seeigecannon/DC404TrainingBadge/render2.png

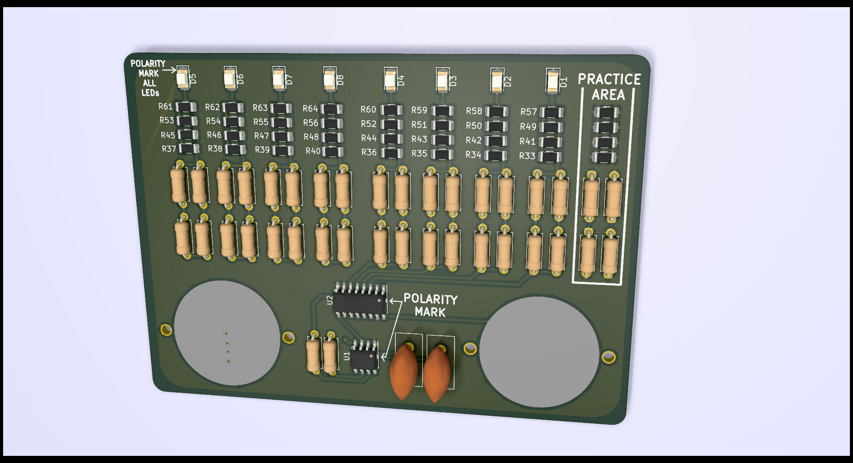
render2.png
