seeigecannon/DC404TrainingBadge/README.md

# DC404TrainingBadge
DC404 Learn to Solder Badge
