seeigecannon/DC404TrainingBadge/render2b.png

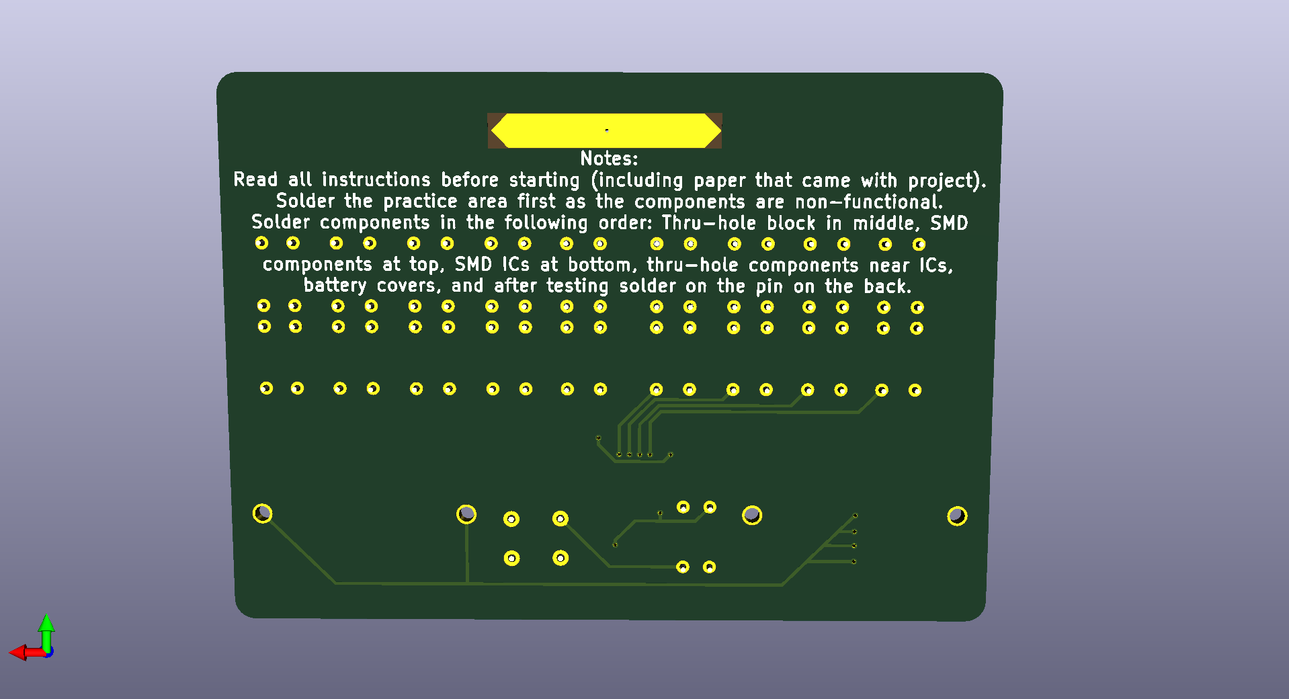
render2b.png
