seeigecannon/DC404TrainingBadge/Printing Print Schematic.pdf

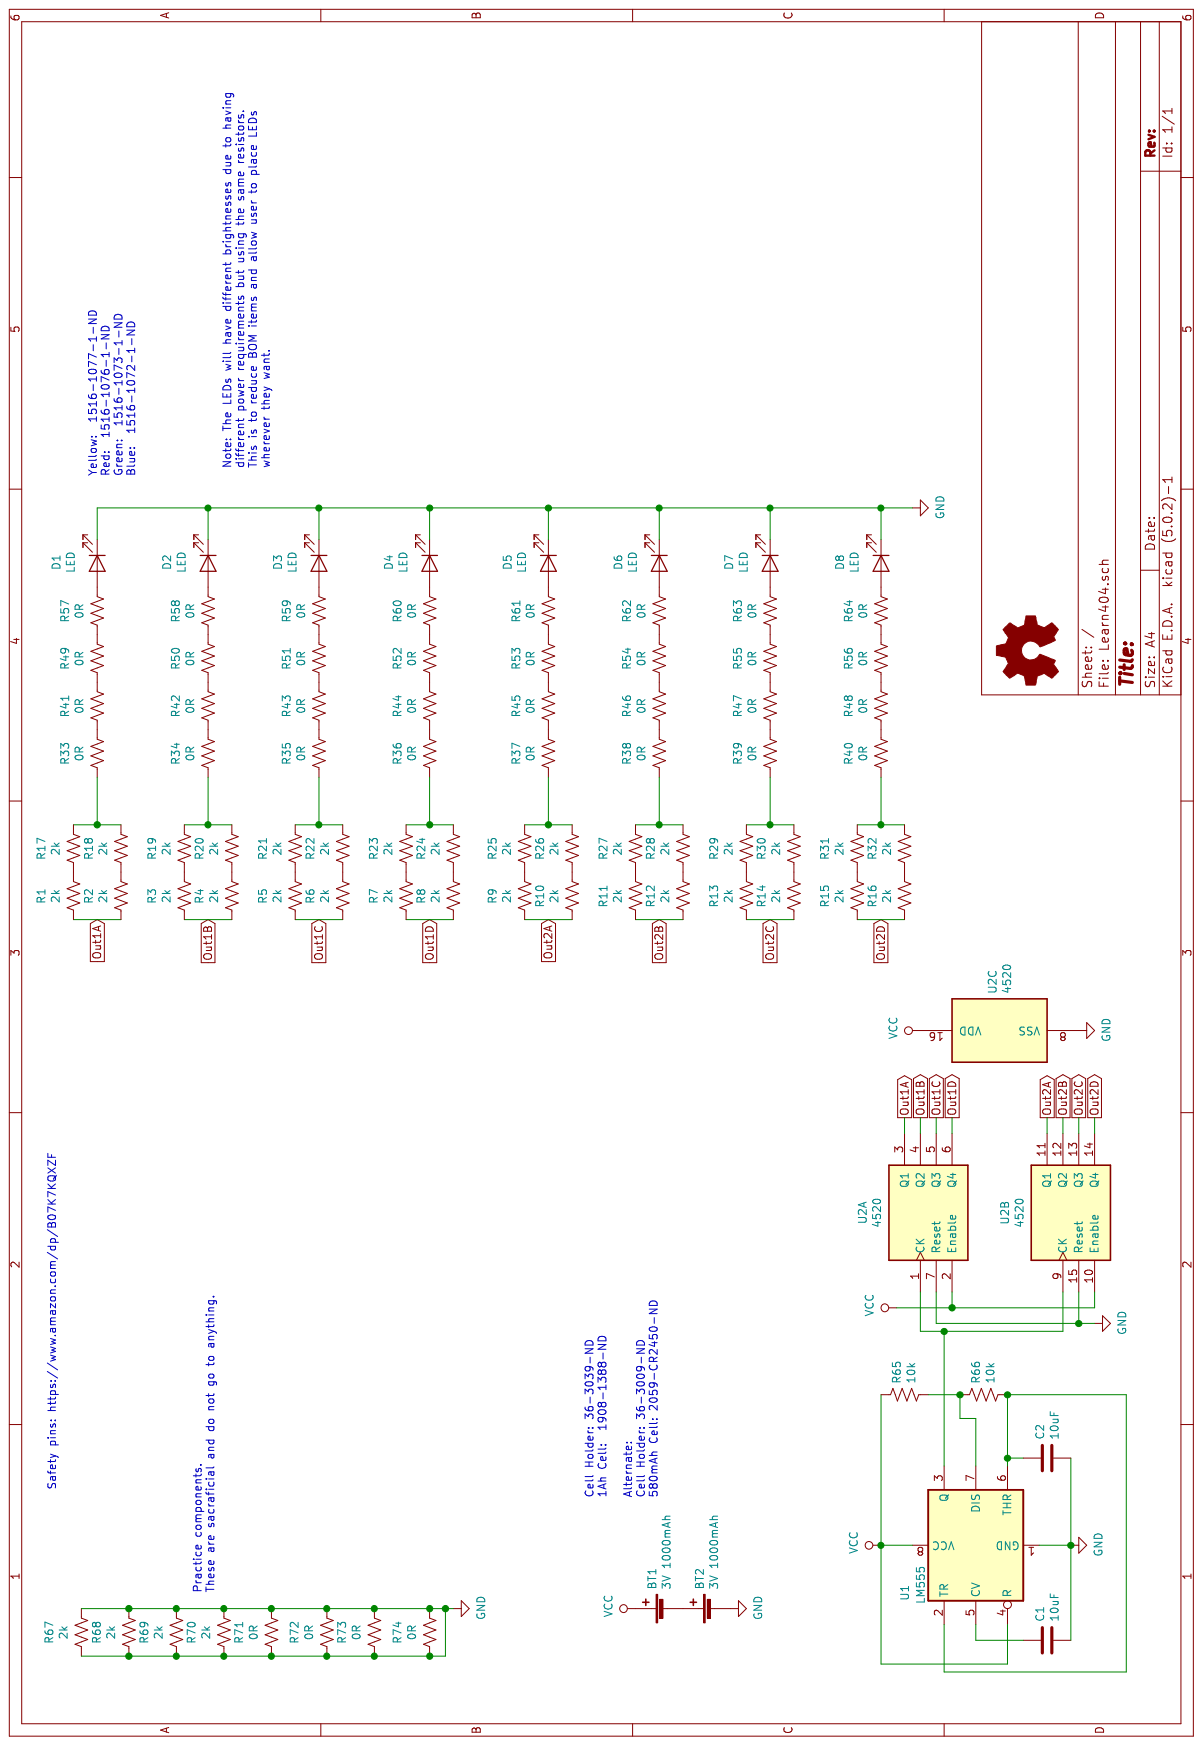
[picture p3: page 1]
