seeigecannon/DC404TrainingBadge/Learn404.kicad_pcb

## KiCad design Learn404.kicad_pcb (2021-06-22)

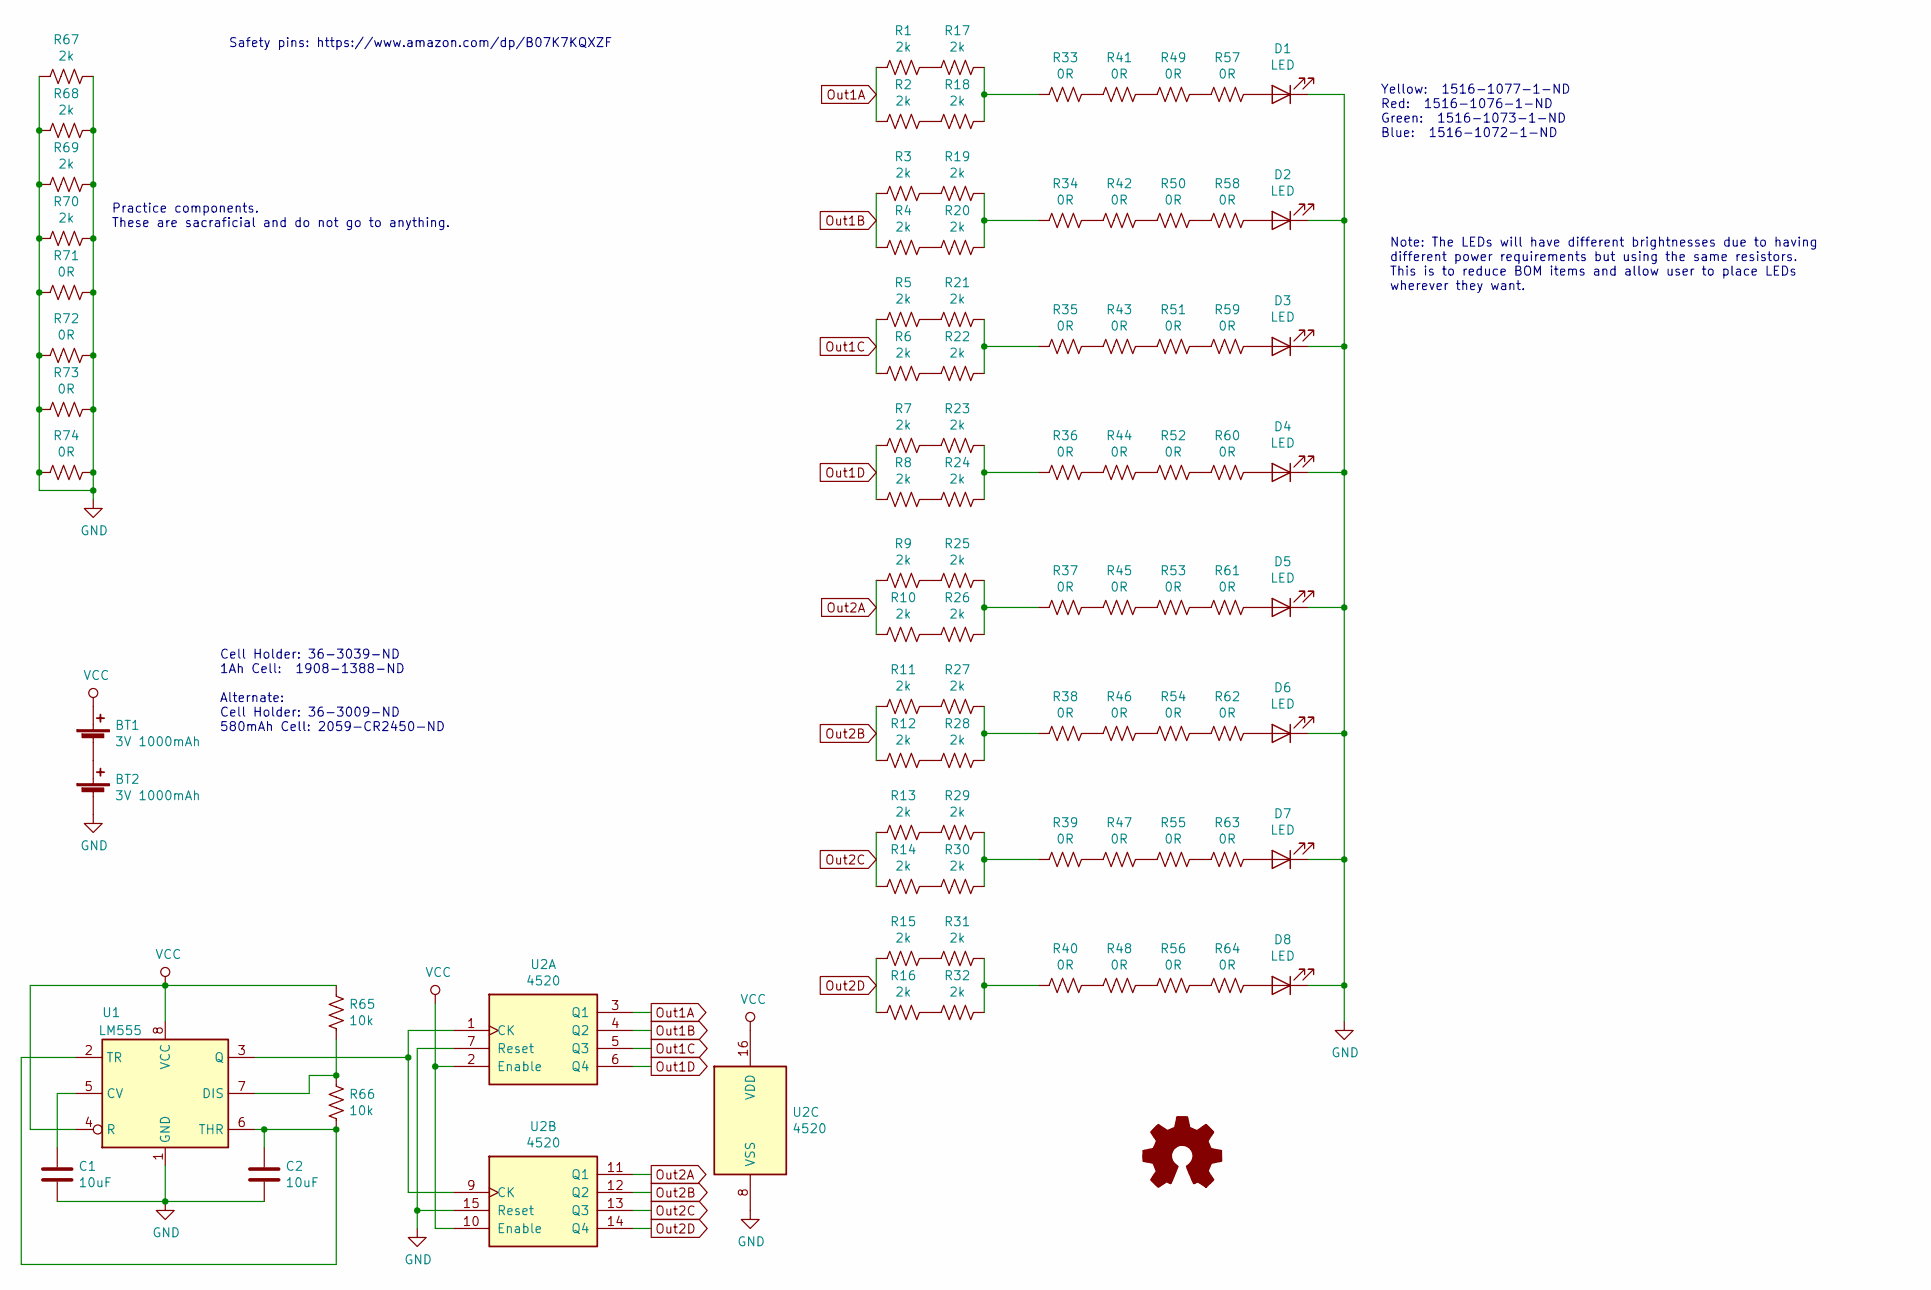
[picture p4: schematic Learn404.sch]

Parts:
BT1, BT2: 3V 1000mAh; BatteryHolder_Keystone_3009_1x2450; PartNum BCAAAPC-ND
C1, C2: 10uF; C_Disc_D10.5mm_W5.0mm_P5.00mm; PartNum FK26X7R1C106K
D1, D2, D3, D4, D5, D6, D7, D8: LED; R_1210_3225Metric_Pad1.42x2.65mm_HandSolder
R1, R2, R3, R4, R5, R6, R7, R8, R9, R10, R11, R12, R13, R14, R15, R16, R17, R18, R19, R20, R21, R22, R23, R24, R25, R26, R27, R28, R29, R30, R31, R32, R67, R68, R69, R70: 2k; R_Axial_DIN0207_L6.3mm_D2.5mm_P10.16mm_Horizontal; Part Number CF14JT2K00CT-ND
R33, R34, R35, R36, R37, R38, R39, R40, R41, R42, R43, R44, R45, R46, R47, R48, R49, R50, R51, R52, R53, R54, R55, R56, R57, R58, R59, R60, R61, R62, R63, R64, R71, R72, R73, R74: 0R; R_1206_3216Metric_Pad1.42x1.75mm_HandSolder; Part Number RMCF1206ZT0R00
R65, R66: 10k; R_Axial_DIN0207_L6.3mm_D2.5mm_P10.16mm_Horizontal; Part Number CF14JT10K0
U1: LM555; SOIC-8_3.9x4.9mm_P1.27mm; PartNum 296-21752-1-ND
U2: 4520; SOIC-16_3.9x9.9mm_P1.27mm; PartNum CD74HCT4520M

Connections:
GND: BT2.2 (-), C1.2, C2.2, D1.1 (K), D2.1 (K), D3.1 (K), D4.1 (K), D5.1 (K), D6.1 (K), D7.1 (K), D8.1 (K), R67.1, R67.2, R68.1, R68.2, R69.1, R69.2, R70.1, R70.2, R71.1, R71.2, R72.1, R72.2, R73.1, R73.2, R74.1, R74.2, U1.1 (GND), U2.7 (Reset), U2.8 (VSS), U2.15 (Reset)
unnamed: BT1.2 (-), BT2.1 (+)
unnamed: C1.1, U1.5 (CV)
unnamed: C2.1, R66.1, U1.2 (TR), U1.6 (THR)
unnamed: D1.2 (A), R57.1
unnamed: D2.2 (A), R58.1
unnamed: D3.2 (A), R59.1
unnamed: D4.2 (A), R60.1
unnamed: D5.2 (A), R61.1
unnamed: D6.2 (A), R62.1
unnamed: D7.2 (A), R63.1
unnamed: D8.2 (A), R64.1
unnamed: R1.1, R17.2
unnamed: R10.1, R26.2
unnamed: R11.1, R27.2
unnamed: R12.1, R28.2
unnamed: R13.1, R29.2
unnamed: R14.1, R30.2
unnamed: R15.1, R31.2
unnamed: R16.1, R32.2
unnamed: R17.1, R18.1, R33.2
unnamed: R2.1, R18.2
unnamed: R19.1, R20.1, R34.2
unnamed: R3.1, R19.2
unnamed: R4.1, R20.2
unnamed: R21.1, R22.1, R35.2
unnamed: R5.1, R21.2
unnamed: R6.1, R22.2
unnamed: R23.1, R24.1, R36.2
unnamed: R7.1, R23.2
unnamed: R8.1, R24.2
unnamed: R25.1, R26.1, R37.2
unnamed: R9.1, R25.2
unnamed: R27.1, R28.1, R38.2
unnamed: R29.1, R30.1, R39.2
unnamed: R31.1, R32.1, R40.2
unnamed: R33.1, R41.2
unnamed: R34.1, R42.2
unnamed: R35.1, R43.2
unnamed: R36.1, R44.2
unnamed: R37.1, R45.2
unnamed: R38.1, R46.2
unnamed: R39.1, R47.2
unnamed: R40.1, R48.2
unnamed: R41.1, R49.2
unnamed: R42.1, R50.2
unnamed: R43.1, R51.2
unnamed: R44.1, R52.2
unnamed: R45.1, R53.2
unnamed: R46.1, R54.2
unnamed: R47.1, R55.2
unnamed: R48.1, R56.2
unnamed: R49.1, R57.2
unnamed: R50.1, R58.2
unnamed: R51.1, R59.2
unnamed: R52.1, R60.2
unnamed: R53.1, R61.2
unnamed: R54.1, R62.2
unnamed: R55.1, R63.2
unnamed: R56.1, R64.2
unnamed: R65.1, R66.2, U1.7 (DIS)
unnamed: U1.3 (Q), U2.1 (CK), U2.9 (CK)
Out1A: R1.2, R2.2, U2.3 (Q1)
Out1B: R3.2, R4.2, U2.4 (Q2)
Out1C: R5.2, R6.2, U2.5 (Q3)
Out1D: R7.2, R8.2, U2.6 (Q4)
Out2A: R9.2, R10.2, U2.11 (Q1)
Out2B: R11.2, R12.2, U2.12 (Q2)
Out2C: R13.2, R14.2, U2.13 (Q3)
Out2D: R15.2, R16.2, U2.14 (Q4)
VCC: BT1.1 (+), R65.2, U1.4 (R), U1.8 (VCC), U2.2 (Enable), U2.10 (Enable), U2.16 (VDD)

Notes on the sheet:
Yellow: 1516-1077-1-ND Red: 1516-1076-1-ND Green: 1516-1073-1-ND Blue: 1516-1072-1-ND
Cell Holder: 36-3039-ND 1Ah Cell: 1908-1388-ND Alternate: Cell Holder: 36-3009-ND 580mAh Cell: 2059-CR2450-ND
Safety pins: https://www.amazon.com/dp/B07K7KQXZF
Practice components. These are sacraficial and do not go to anything.
Note: The LEDs will have different brightnesses due to having different power requirements but using the same resistors. This is to reduce BOM items and allow user to place LEDs wherever they want.

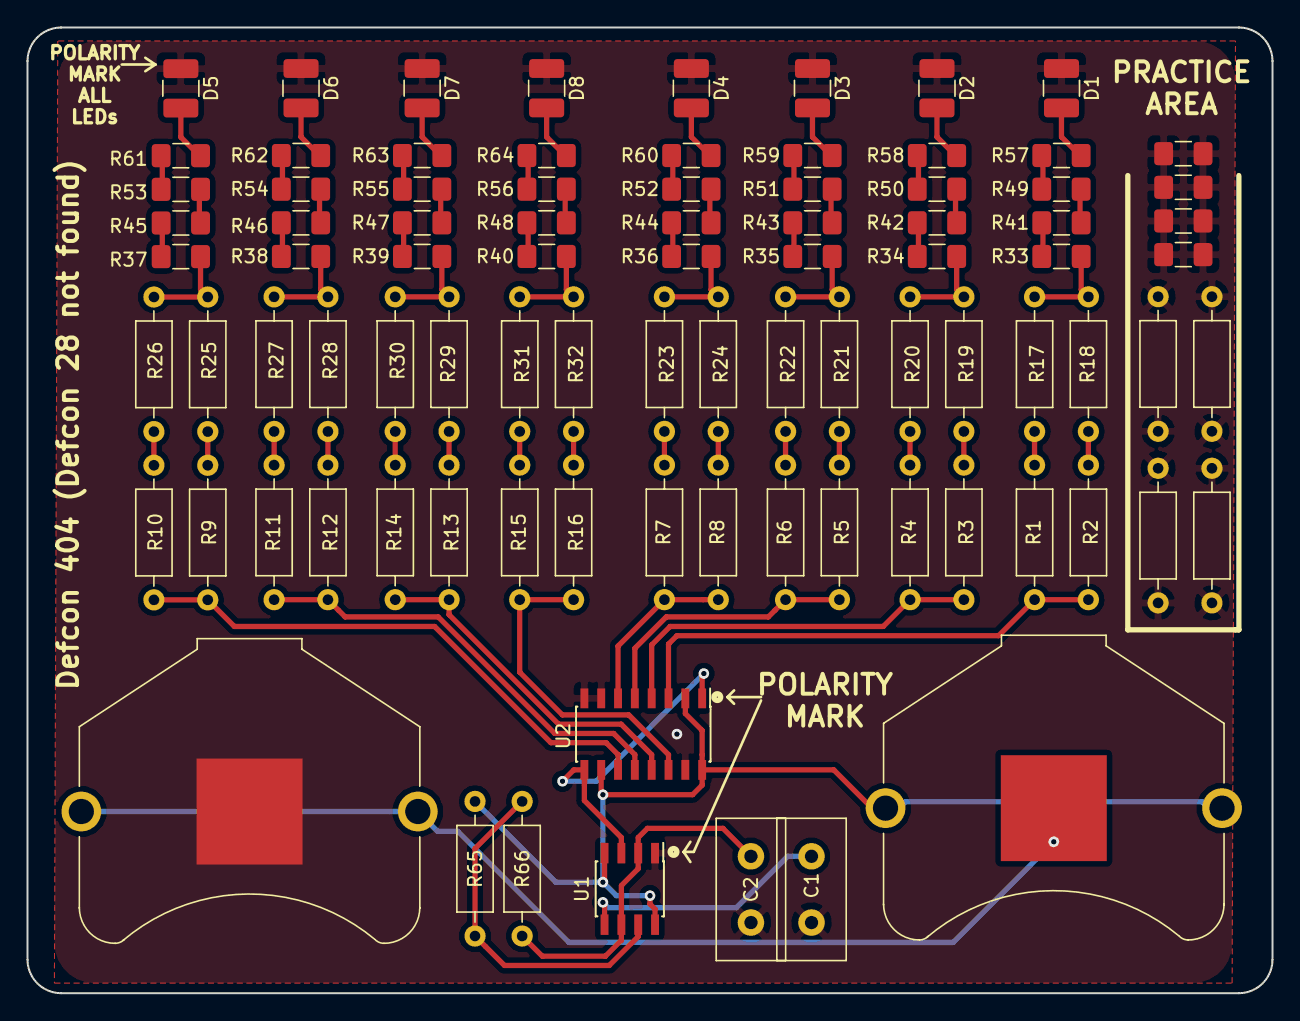
[picture p5: board Learn404.kicad_pcb from above]

Board: 2 copper layers, 94.0 x 72.9 mm, 88 parts (0 on the bottom side), 71 nets.
