seeigecannon/DC404TrainingBadge/Printing Print Schematic.png

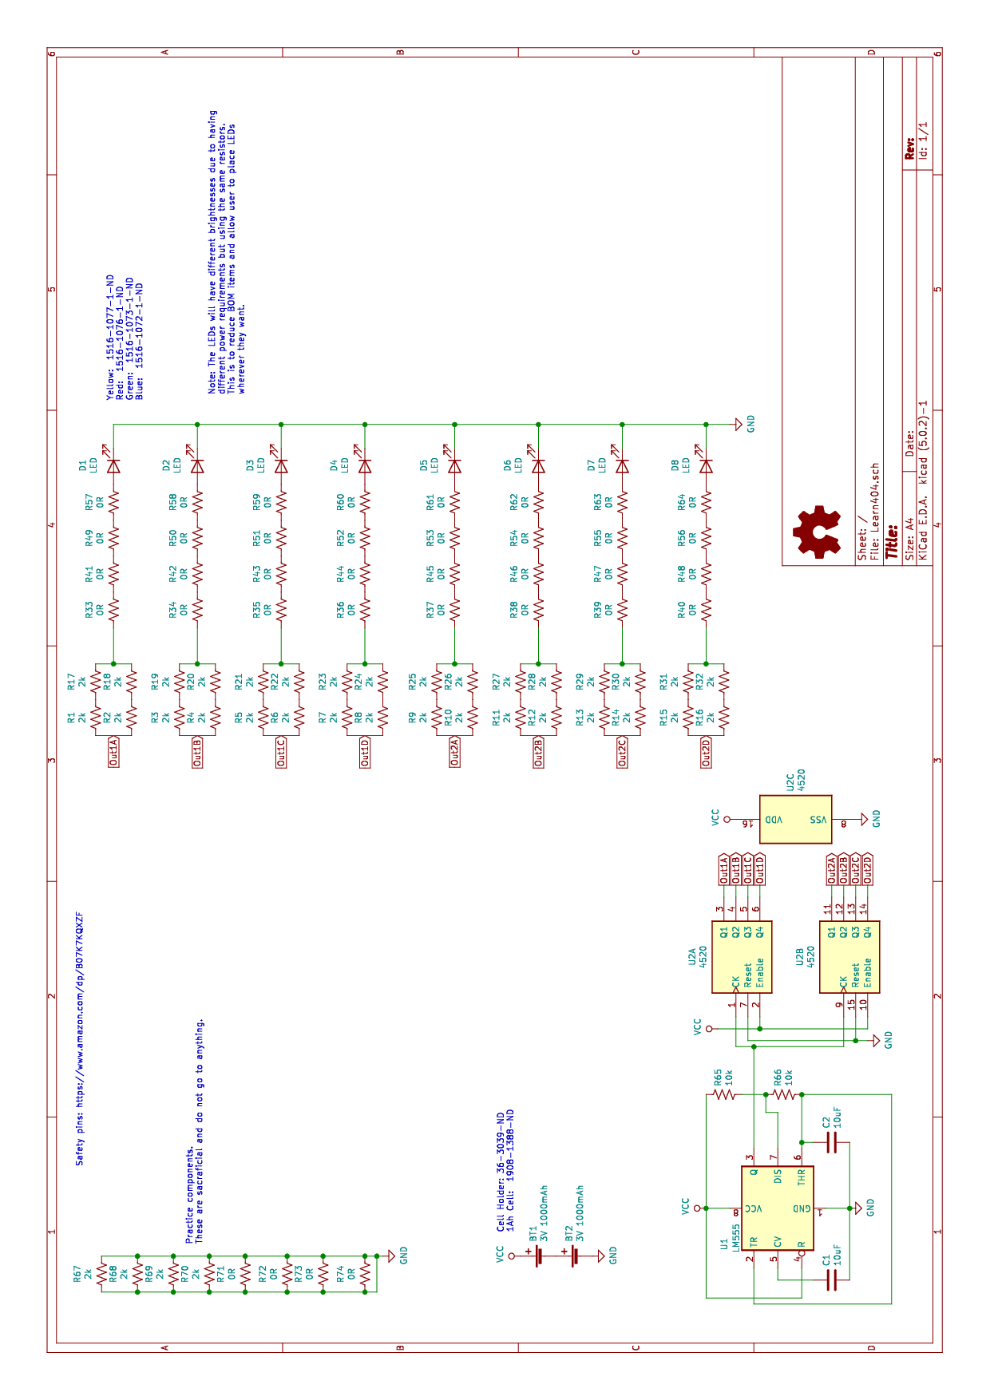
Printing Print Schematic.png
