seeigecannon/DC404TrainingBadge/(commit log)

2020-07-26 Initial upload
    [Learn404.csv, Learn404.kicad_pcb, Learn404.sch]
2021-06-22 Uploaded Rev B files. This board is known to work.
    [Learn404.kicad_pcb, Learn404.sch]
